ampersandmcd/OpenSwarm/Docs/03-Hardware.md

# OpenSwarm Documentation: Hardware

## Design

When designing the physical side of OpenSwarm, simplicity, flexibility, and affordability were of paramount concern. To study advanced swarm control algorithms requires an adaptable and robust physical foundation; to enable innovation in software, hardware must not get in the way.

As such, hardware design choices were kept generic and open-source; the goal was to keep attention on _what could be done_ with the system, rather than _on the system itself._ The result: an open-source, accessible, portable and hardware-agnostic swarm robotics control framework for the advancement of algorithmic research in distributed systems, multi-agent systems and human-robot interaction.

### Robot

A bi-wheeled, [Arduino](https://www.arduino.cc/)-controlled robot design was chosen for simplicity, flexibility, and affordability's sake; at under $80 per robot, a testbed and swarm of 5 robots can be constructed for under $500. Extensive documentation on the open-source Arduino project is available online along with countless open-source libraries, making the platform ideal for low-cost, high-speed development. Standardized 5V logic and jumper-cable-friendly I/O further solidifes Arduino as the gold-standard of research-oriented development.

WiFi connectivity is provided by the [ESP8266 board](https://en.wikipedia.org/wiki/ESP8266), and mobility is provided by two generic 5v DC motors under control of an [Adafruit TB6612](https://learn.adafruit.com/adafruit-tb6612-h-bridge-dc-stepper-motor-driver-breakout/overview) motor driver. Both components were again chosen on the criteria of simplicity, flexibility, and affordability.

### Testbed

To keep with the theme of simplicity, flexibility, and affordability, the testbed consists of only three parts: open floor space (25-100 ft<sup>2</sup>), an overhead webcam for visual tracking and robot localization, and a router to enable UDP communication between a central server and client robots. These three elements are all that's needed to turn a classroom, basement, or bedroom into one's own research lab.

## Architecture

### Robot

Included below is a bill of materials necessary for each robot's construction, followed by a wiring diagram and images of a finished robot. Note that the photoresistor is optional, and could be replaced by any sensor relevant to the nature of an experiment for data feedback to the central server.

| Item | Quantity | Price |
| --- | --- | --- |
| [Arduino UNO R3](https://www.amazon.com/ELEGOO-Board-ATmega328P-ATMEGA16U2-Compliant/dp/B01EWOE0UU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) | 1 | \$12 |
| [ESP8266](https://www.amazon.com/KeeYees-Internet-Development-Wireless-Compatible/dp/B07PR9T5R5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) | 1 | \$7 |
| [Adafruit TB6612](https://www.amazon.com/Adafruit-TB6612-Stepper-Driver-Breakout/dp/B00VY32VU4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) | 1 | \$5 |
| [Adafruit 3-Layer Round Robot Chassis 2WD with DC Motors](https://www.adafruit.com/product/3244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) | 1 | \$30 |
| [Assorted Jumper Cables](https://www.amazon.com/ELEGOO-Solderless-Flexible-Breadboard-Arduino/dp/B01EV47GI4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) | 1 | \$8 |
| [Generic 9v Battery](https://www.amazon.com/AmazonBasics-Everyday-Alkaline-Batteries-8-Pack/dp/B00MH4QM1S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) | 2 | \$1 |
| [Generic 400-pin Breadboard](https://www.amazon.com/Breadboard-Solderless-Prototype-PCB-Board/dp/B077DN2PS1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) | 2 | \$5 |
| [Generic 9v Battery Hookup](https://www.amazon.com/Battery-Connector-Leather-Housing-Connection/dp/B06X8YZJ64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) | 2 | \$0.50  |
| [Generic 4-Pin Terminal](https://www.amazon.com/Antrader-5-08mm-4P-Pluggable-Terminal-Connector/dp/B07B9R5BQH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) | 1 | \$0.50  |
| [Generic 7805 Voltage Regulator](https://www.amazon.com/Voltage-Regulator-Linear-L7805CV-Positive/dp/B07H9M9SFM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) | 1 | \$0.50  |
| [Generic 0.1uF Capacitor](https://www.amazon.com/Projects-B-0002-C11-Ceramic-Capacitor-0-1uF/dp/B00E6PNOXU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)  | 1 | \$0.50  |
| [Generic 6-Pin Switch](https://www.amazon.com/Position-Vertical-Switch-Electronics-Project/dp/B07F7PNDGM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) | 2 | \$0.50  |
| [Generic LED](https://www.amazon.com/Lights-Emitting-Assortment-Arduino-300-Pack/dp/B00UWBJM0Q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) | 5 | \$0.50  |
| [Generic Potentiometer](https://www.amazon.com/Trimpot-Variable-Resistor-Potentiometer-Assortment/dp/B071WW6VN8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) | 1 | \$0.50  |
| [Generic 220Ω Resistor](https://www.amazon.com/AUSTOR-Resistors-Assortment-Resistor-Experiments/dp/B07BKRS4QZ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) | 5 | \$0.50  |
| [Generic 400-pin Breadboard](https://www.amazon.com/Breadboard-Solderless-Prototype-PCB-Board/dp/B077DN2PS1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) | 2 | \$5 |
| [(Optional) Generic Photoresistor](https://www.amazon.com/MCIGICM-Photoresistor-Sensitive-Resistor-Dependent/dp/B07PF3CWW9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) | 1 | \$0.50  |
| [(Optional) 3D Printed Casing]() | 1 | \$2 |
| **Total** | | \$79.50 |

The schematic below (from [this Fritzing file](../Hardware/Fritzing/RobotSchematic.fzz)) diagrams the architecture of each OpenSwarm robot:

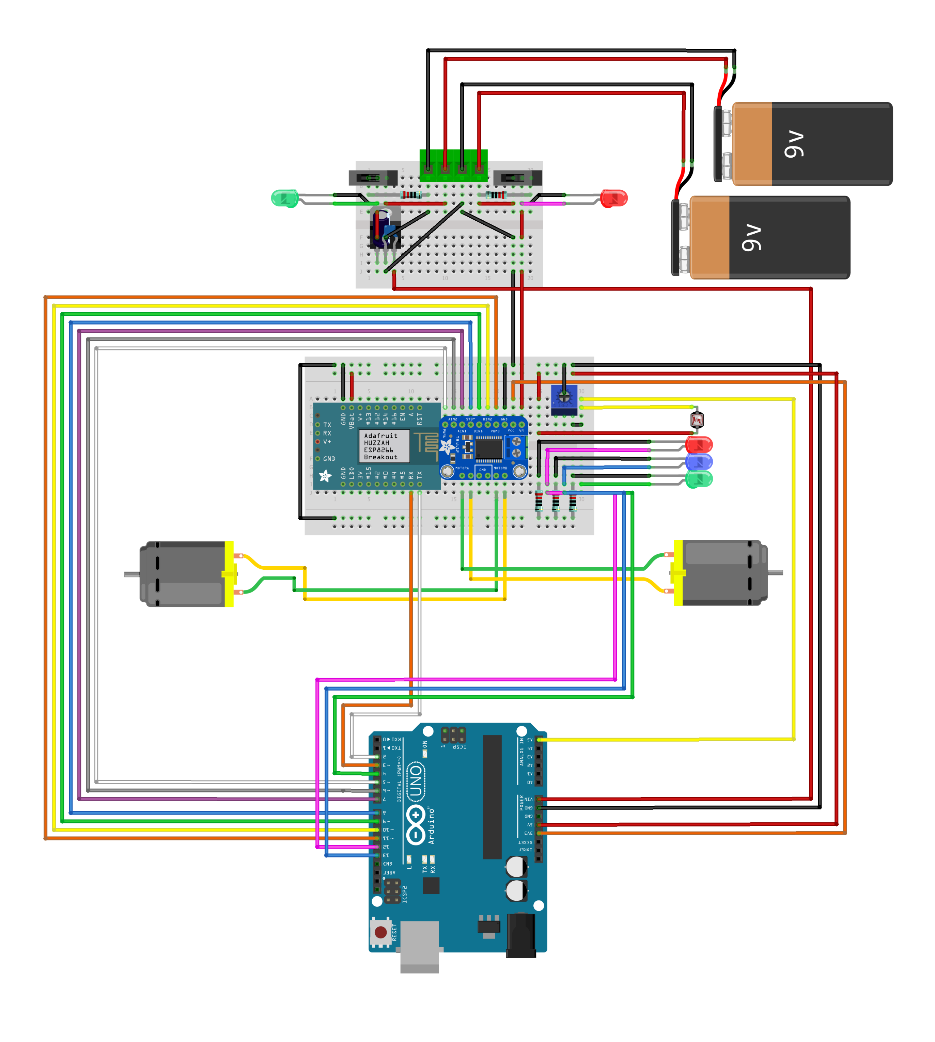
[picture p2: Docs/Images/RobotSchematic.png]


An assembled robot with breadboards, motors, and controllers mounted to an [Adafruit 3-Layer Chassis](https://www.adafruit.com/product/3244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):

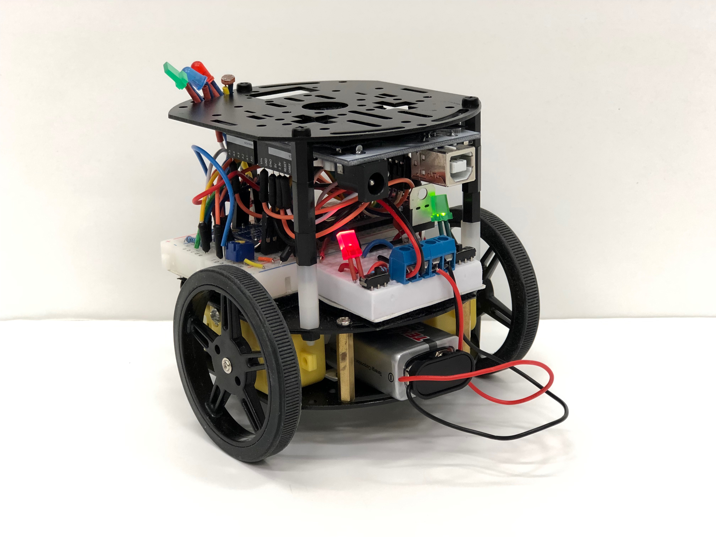
[picture p3: Docs/Images/ISO-Robot-Uncovered.JPG]


An assembled robot complete with [3D-printed casing](../Hardware/3DModels/RobotCover.stl) and visual tracking anchors:

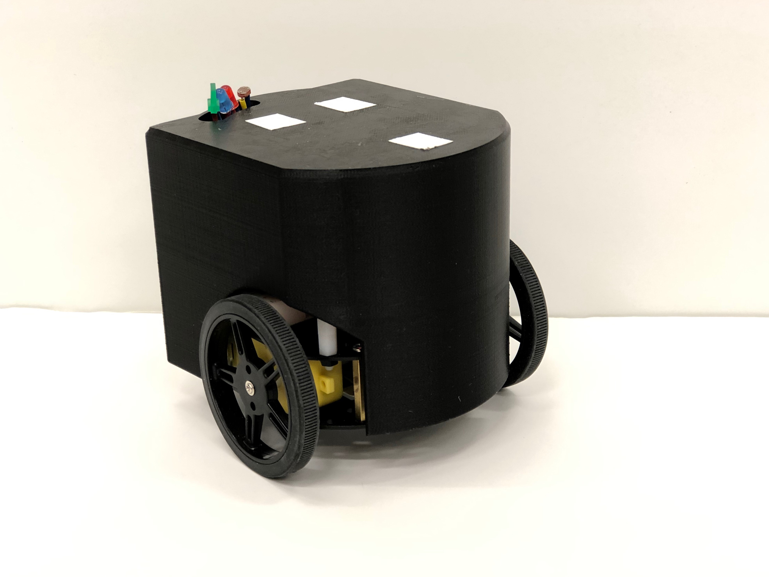
[picture p4: Docs/Images/ISO-Robot-Covered.JPG]


### Testbed

Included below is a bill of materials necessary for the testbed's construction, followed by a conceptual diagram of the testbed and images of the one used when developing OpenSwarm.

| Item | Quantity | Price |
| --- | --- | ----- |
| [Generic Webcam (resolution ≥ 1024x768)](https://www.amazon.com/LARMTEK-Webcam-Computer-Conference-Calling/dp/B07P84DN2K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) | 1 | \$30  |
| [Generic Router](https://www.amazon.com/TP-Link-N450-Wi-Fi-Router-TL-WR940N/dp/B001FWYGJS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) | 1 | \$20  |
| Open Floor Space (25-100 ft<sup>2</sup>) with Overhead Mount for Webcam | 1 | - |
| **Total** | | \$50  |

A conceptual diagram of the testbed setup:

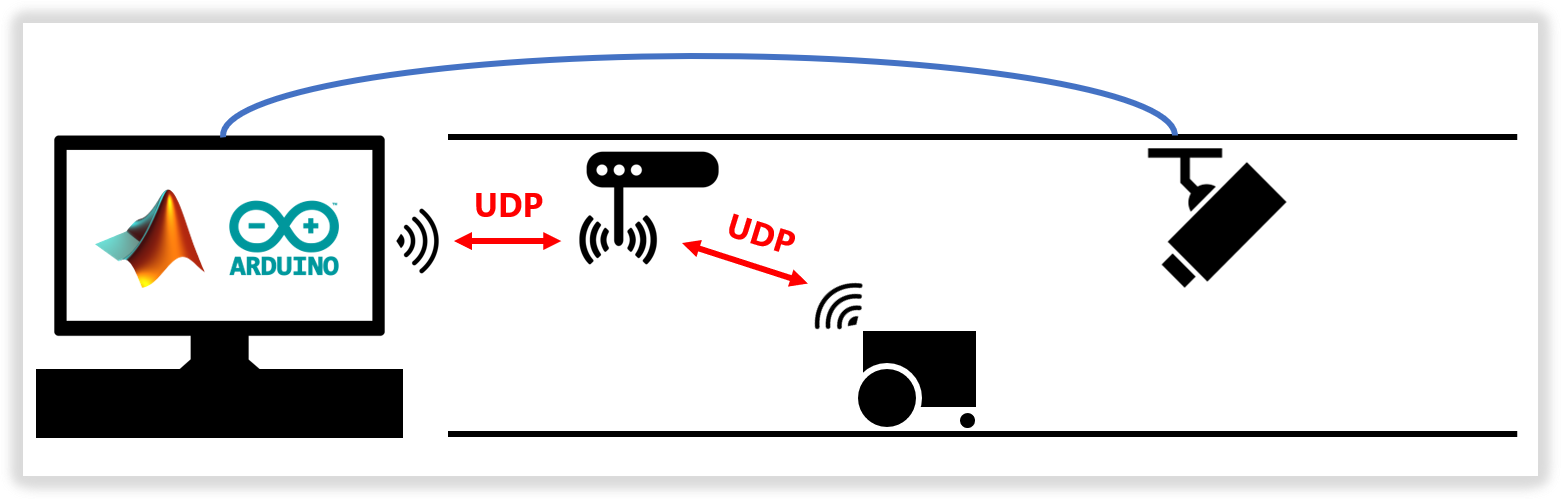
[picture p5: Docs/Images/TestbedSchematic.png]


Testbed used to develop OpenSwarm (approximately 10ft x 10ft; router not pictured). Note that the dark flooring enables visual tracking of the white anchor points on each robot:



Webcams mounted above the testbed used to develop OpenSwarm; note that only one is necessary for visual tracking in Matlab (the second is for simultaneous video capture when running experiments):

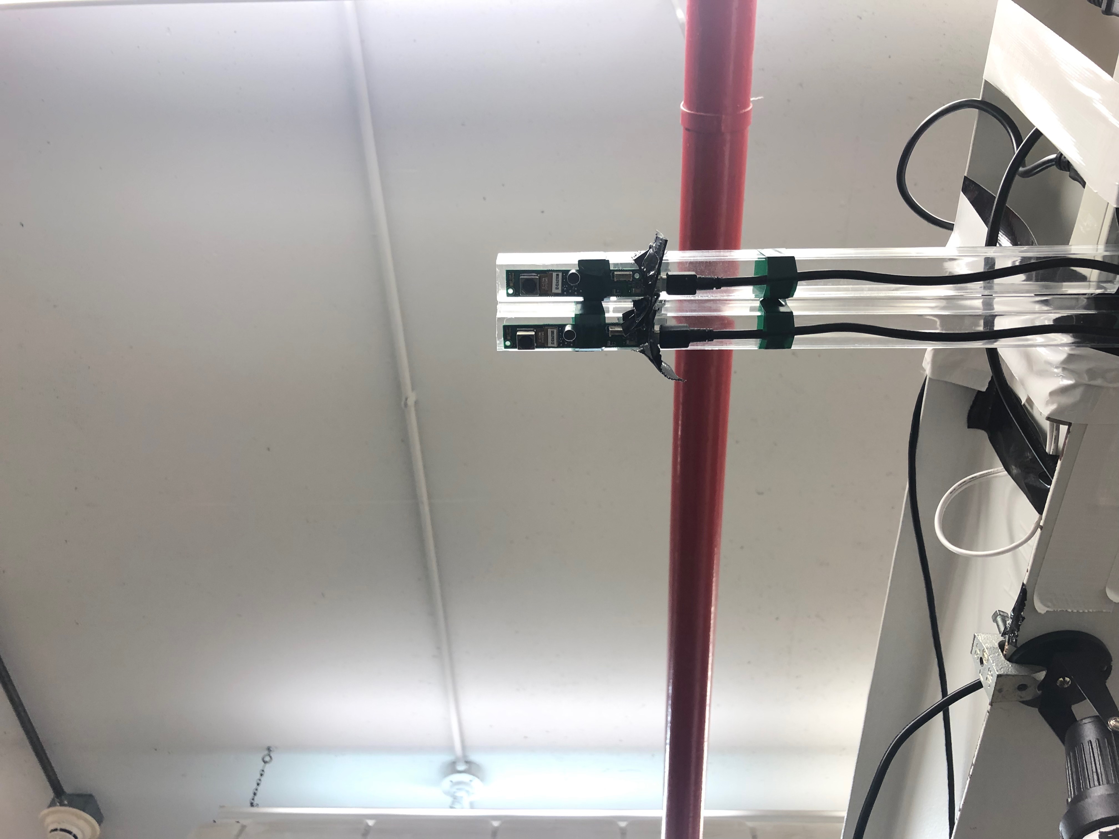
[picture p6: Docs/Images/TestbedWebcam.JPG]


<a href=02-Getting-Started.md>Previous: Getting Started</a>

<a href=04-Software.md>Next: Software</a>
