ampersandmcd/OpenSwarm/Docs/06-References.md

# OpenSwarm Documentation: References

The OpenSwarm library leverages a number of online projects as dependencies, and does not claim ownership or authorship of any of them. Rather, they are included in the repository for the sake of convenience and version stability; it is known that the included versions integrate properly with OpenSwarm's codebase.

As creators of OpenSwarm, we express our most sincere gratitude and respect to those who developed each project. Without each of them, OpenSwarm would not have been possible.

For more information about and most recent versions of each dependency, visit the links below.

### Arduino

- [avr Arduino Core Library](https://github.com/arduino/ArduinoCore-avr)
- [MMEmotor Library](http://web.cecs.pdx.edu/~gerry/class/ME491/notes/motor_driver_TB6612_hookup.html)
- [avr-libc/util Library](https://www.nongnu.org/avr-libc/user-manual/dir_586ad3c2f85d776b984733890d824e3e.html)
- [WiFiEsp Library](https://github.com/bportaluri/WiFiEsp)

### ESP

- [ESP Flash Download Tool](https://www.espressif.com/en/support/download/other-tools)
- [ESP8266 NONOS SDK](https://github.com/espressif/ESP8266_NONOS_SDK)

### Matlab

- [Gaussian Processes for Machine Learning (gpml) Library](http://www.gaussianprocess.org/gpml/)
- [Lloyd's Algorithm Implementation by Aaron Becker](https://www.mathworks.com/matlabcentral/fileexchange/41507-lloydsalgorithm-px-py-crs-numiterations-showplot)
- [Minimum Enclosing Circle Algorithm Implementation by Yazan Ahed](https://www.mathworks.com/matlabcentral/fileexchange/6457-minimum-enclosing-circle)
