ampersandmcd/OpenSwarm/Docs/Images/Diagrams.pptx

Target Positions

OpenSwarm

- Tracks, logs, and returns robot positions to control algorithm
- Determines directions to send to each robot given current and target positions
- Sends directional commands until robots converge on targets
- Receives, logs, and returns sensor data read by each robot

Control Algorithm

- Processes system state data from OpenSwarm
- Updates robot target positions with objective function
- Returns new target positions to OpenSwarm

Current Positions
Past Positions
Current Sensor Data
Past Sensor Data

## Slide 2

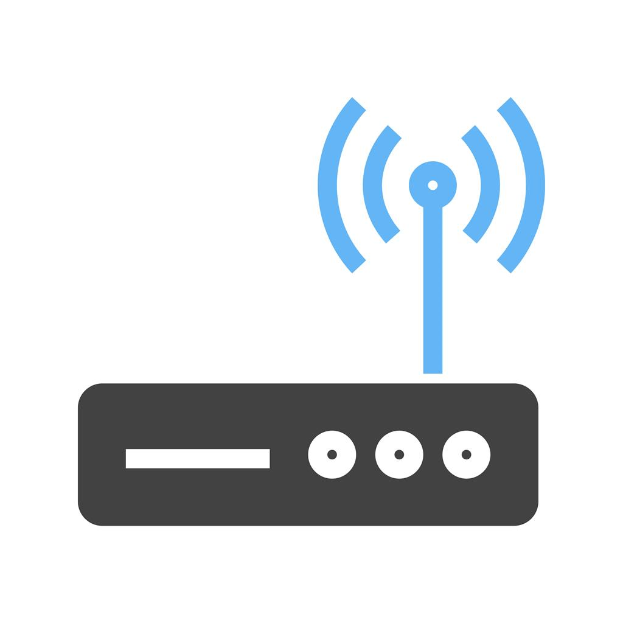
[picture p8: figure]
Image result for router icon
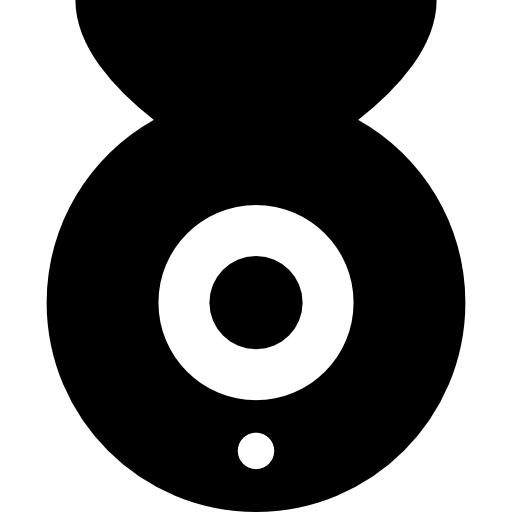
[picture p9: figure]
Image result for webcam icon

5’-10’

5’-10’

## Slide 3

Nose

Tail

Robot L

Robot R
