ampersandmcd/OpenSwarm/Docs/00-Table-of-Contents.md

# OpenSwarm Documentation: Table of Contents

## Table of Contents

1. [Introduction](01-Introduction.md)
   - What is Swarm Robotics?
   - What is OpenSwarm?
   - What's Next?
1. [Getting Started](02-Getting-Started.md)
   - Testbed Setup
   - Robot Setup
   - Software Setup
   - Next Steps
1. [Hardware](03-Hardware.md)
   - Design Considerations
     - Robot
     - Testbed
   - Architecture Overview
     - Robot
     - Testbed
1. [Software](04-Software.md)
   - Design Considerations
     - Server-Side (Matlab)
     - Client-Side (Arduino)
   - Architecture Overview
     - Server-Side (Matlab)
     - Client-Side (Arduino)
1. [Demos](05-Demos.md)
   - Pathfinder

## Appendices

1. [Troubleshooting](A1-Troubleshooting.md)
2. [Contact](A2-Contact.md)

<a href=01-Introduction.md>Next: Introduction</a>
