ampersandmcd/OpenSwarm/Docs/Images/ArduinoFlow.png

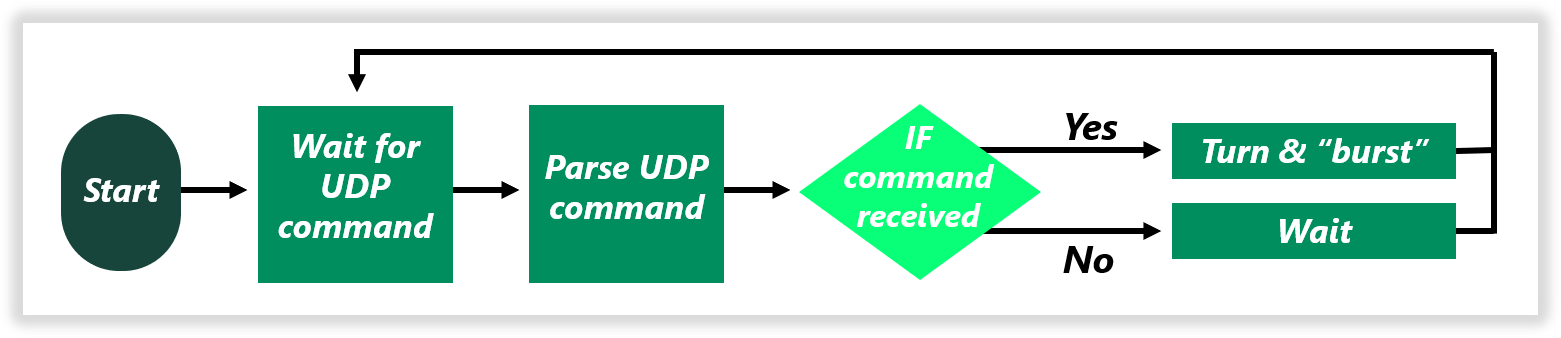
Docs/Images/ArduinoFlow.png
