ampersandmcd/OpenSwarm/Docs/Images/MatlabFlow.png

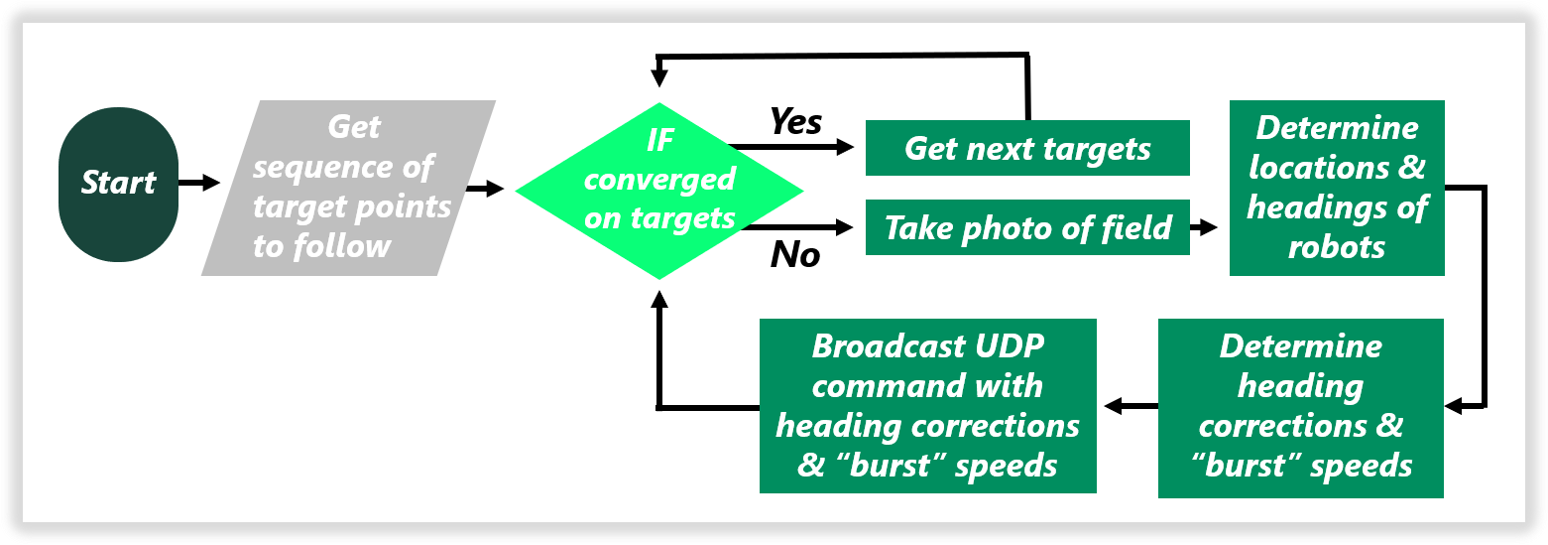
Docs/Images/MatlabFlow.png
