ampersandmcd/OpenSwarm/Docs/Images/SwarmCircleThumbnail.PNG

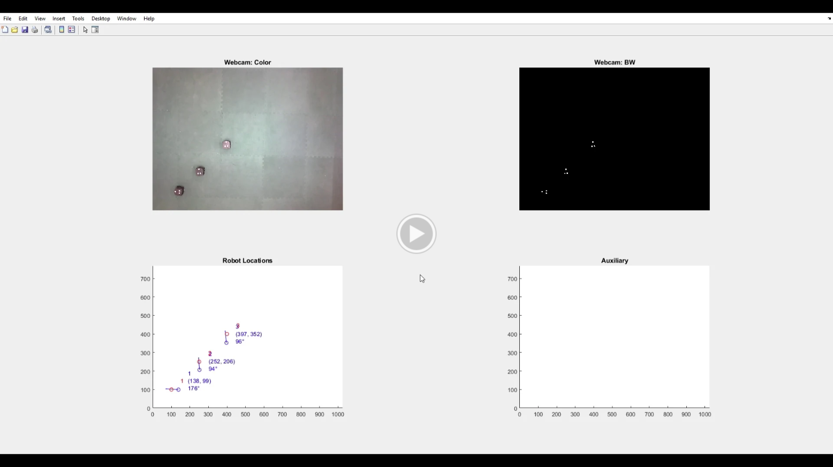
Docs/Images/SwarmCircleThumbnail.PNG
