ampersandmcd/OpenSwarm/Matlab/Data/prior5_confidence0.8.PNG

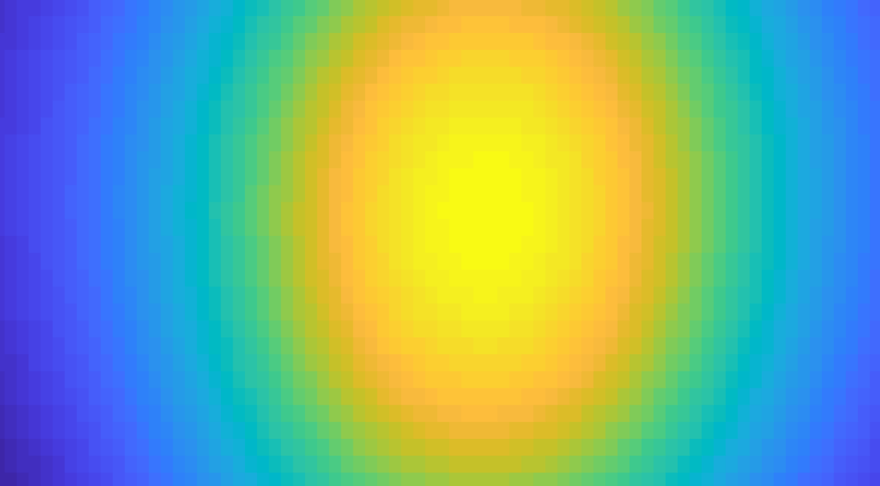
Matlab/Data/prior5_confidence0.8.PNG
