ampersandmcd/OpenSwarm/Matlab/Data/prior5_confidence0.8_winter.PNG

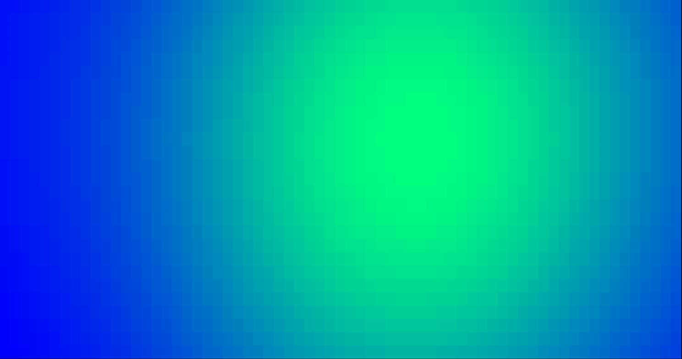
Matlab/Data/prior5_confidence0.8_winter.PNG
