ampersandmcd/OpenSwarm/Matlab/Data/prior6_confidence0.8_winter.PNG

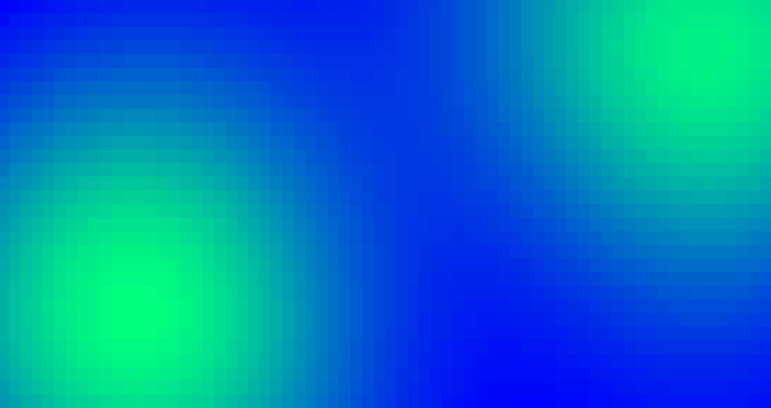
Matlab/Data/prior6_confidence0.8_winter.PNG
