ampersandmcd/OpenSwarm/Media/2.19.19 Panorama BW.jpg

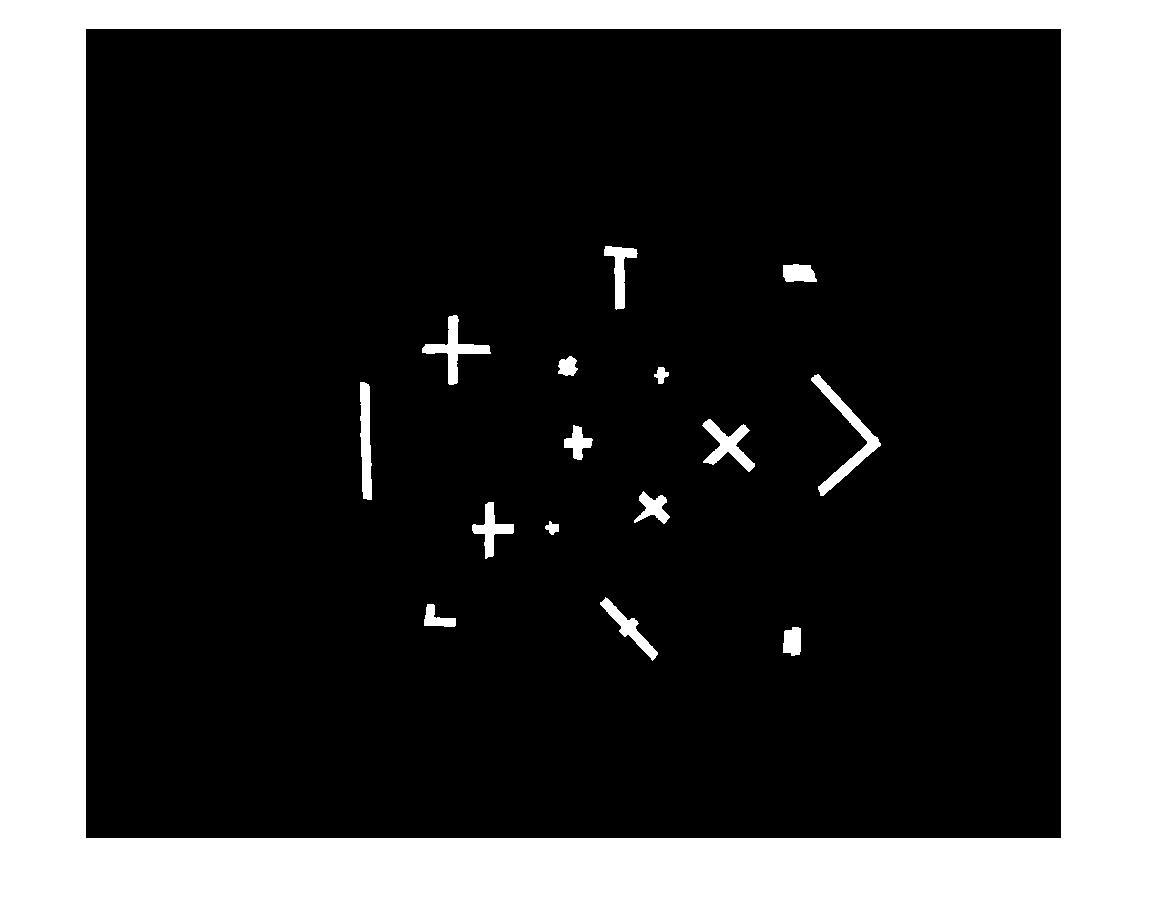
Media/2.19.19 Panorama BW.jpg
