ampersandmcd/OpenSwarm/Media/2.19.19 Panorama Crop.jpg

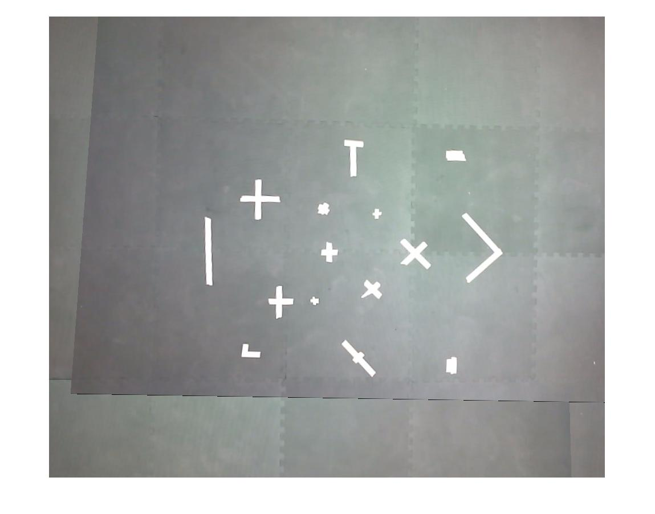
Media/2.19.19 Panorama Crop.jpg
