ampersandmcd/OpenSwarm/Media/2.19.19 Panorama.jpg

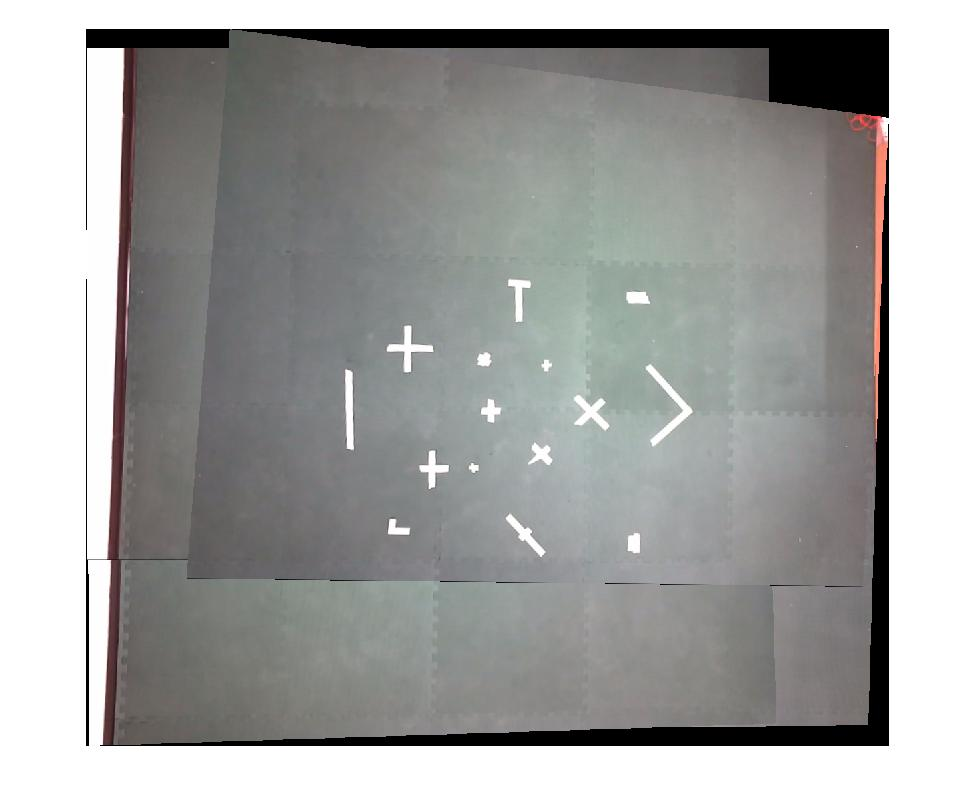
Media/2.19.19 Panorama.jpg
