ampersandmcd/OpenSwarm/Media/2.22.19 Successful Position & Heading Tracking.PNG

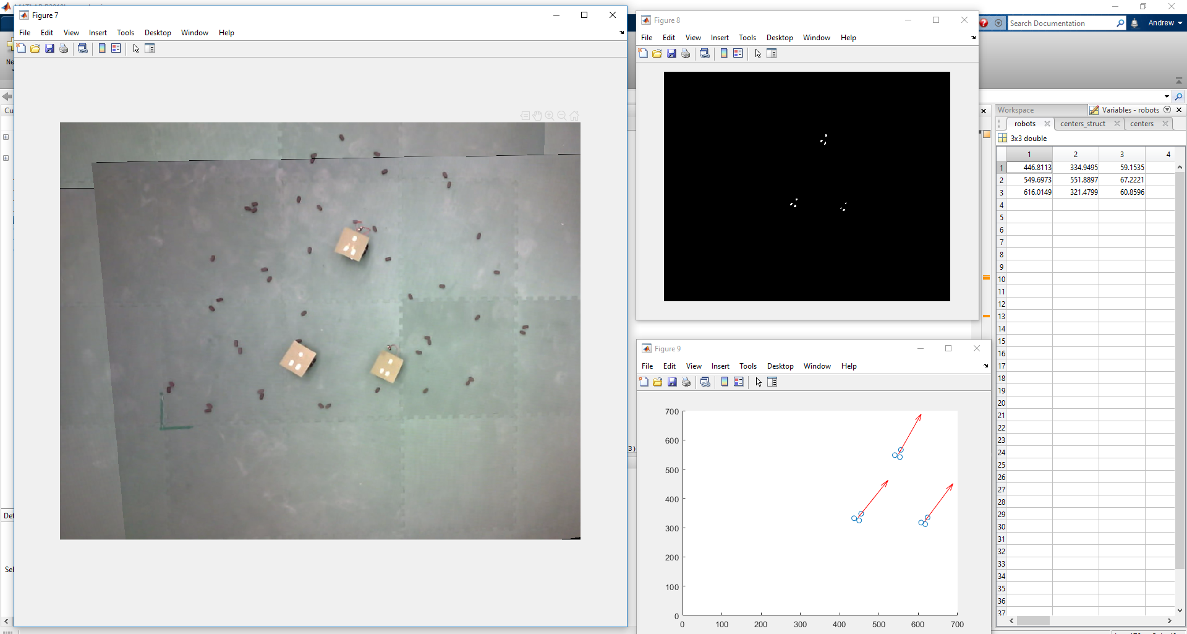
Media/2.22.19 Successful Position & Heading Tracking.PNG
