ampersandmcd/OpenSwarm/Media/AAAI_Exploit1.png

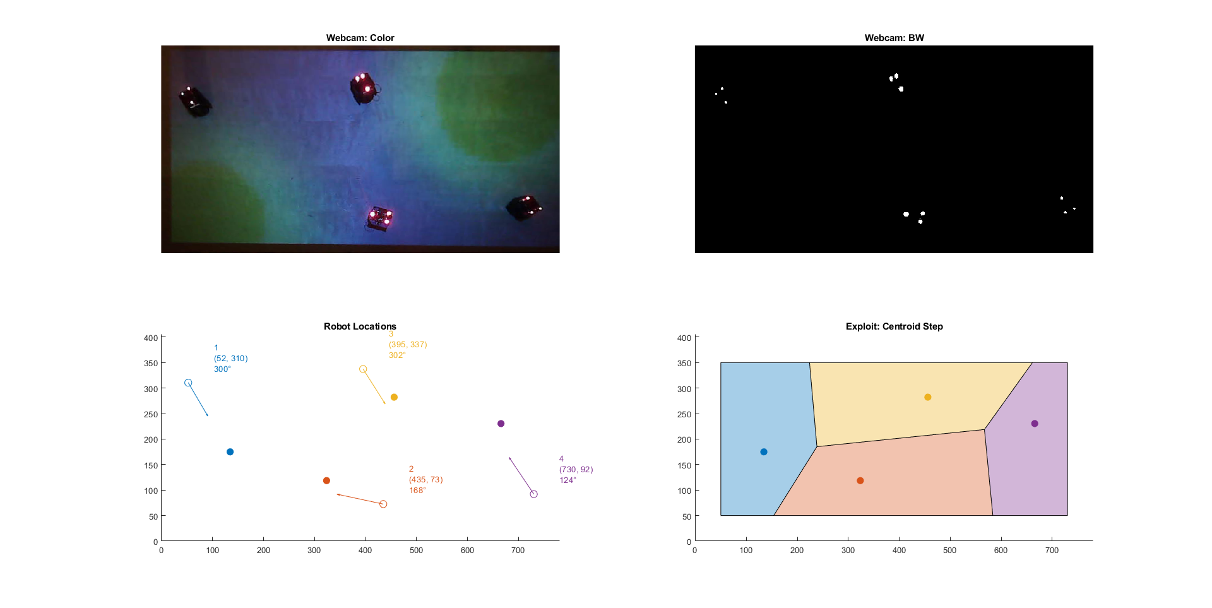
Media/AAAI_Exploit1.png
