ampersandmcd/OpenSwarm/Media/AAAI_Explore1.png

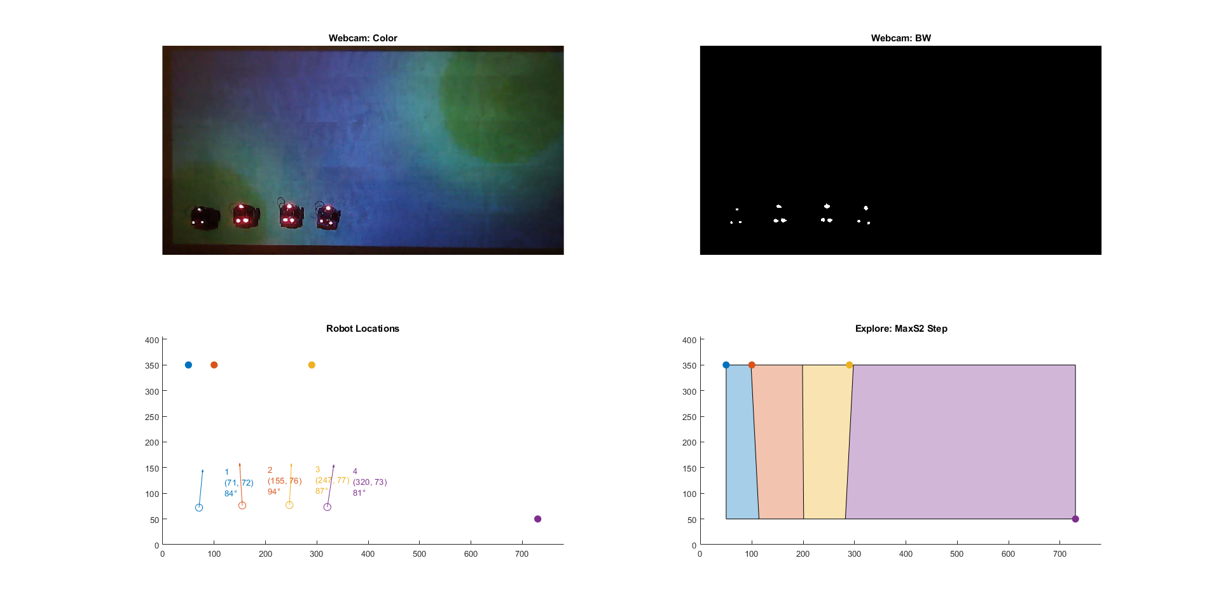
Media/AAAI_Explore1.png
