ampersandmcd/OpenSwarm/Media/AAAI_Explore3.png

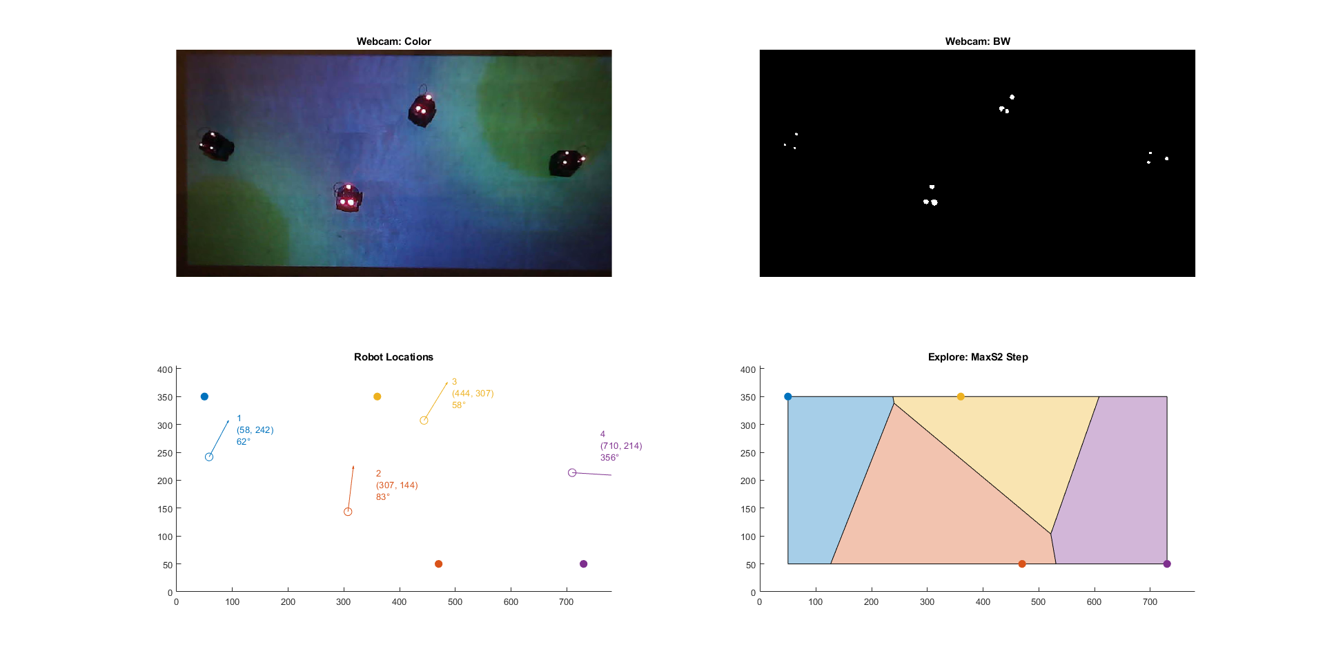
Media/AAAI_Explore3.png
