ampersandmcd/OpenSwarm/Media/AAAI_GP2.png

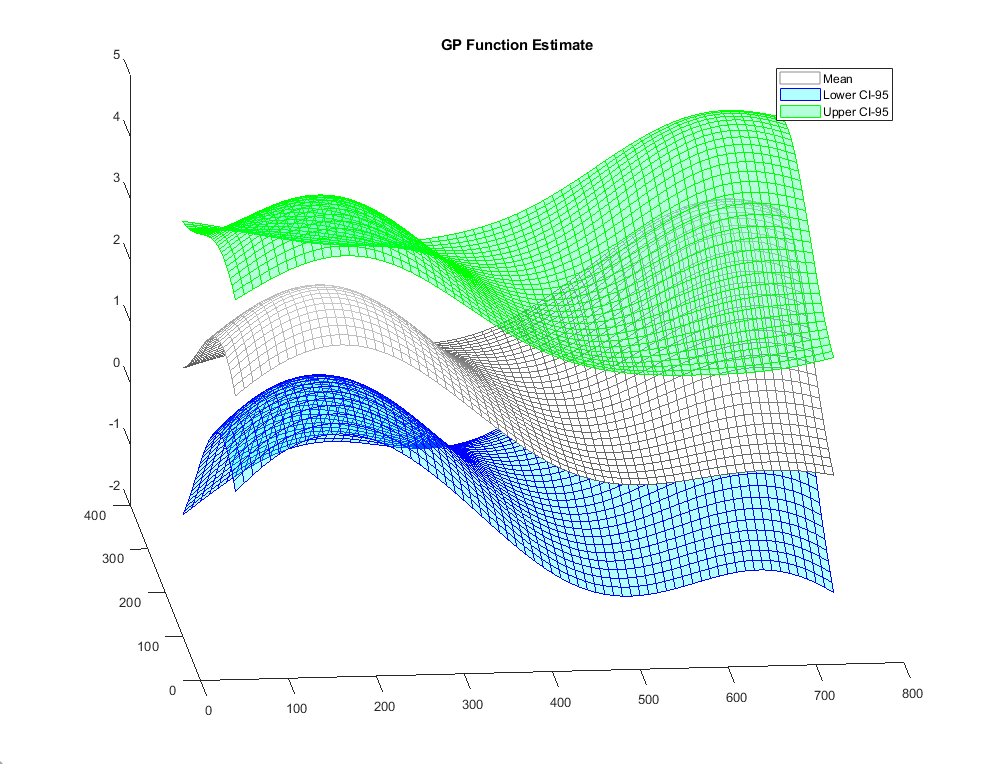
Media/AAAI_GP2.png
