ampersandmcd/OpenSwarm/Media/AAAI_GP.png

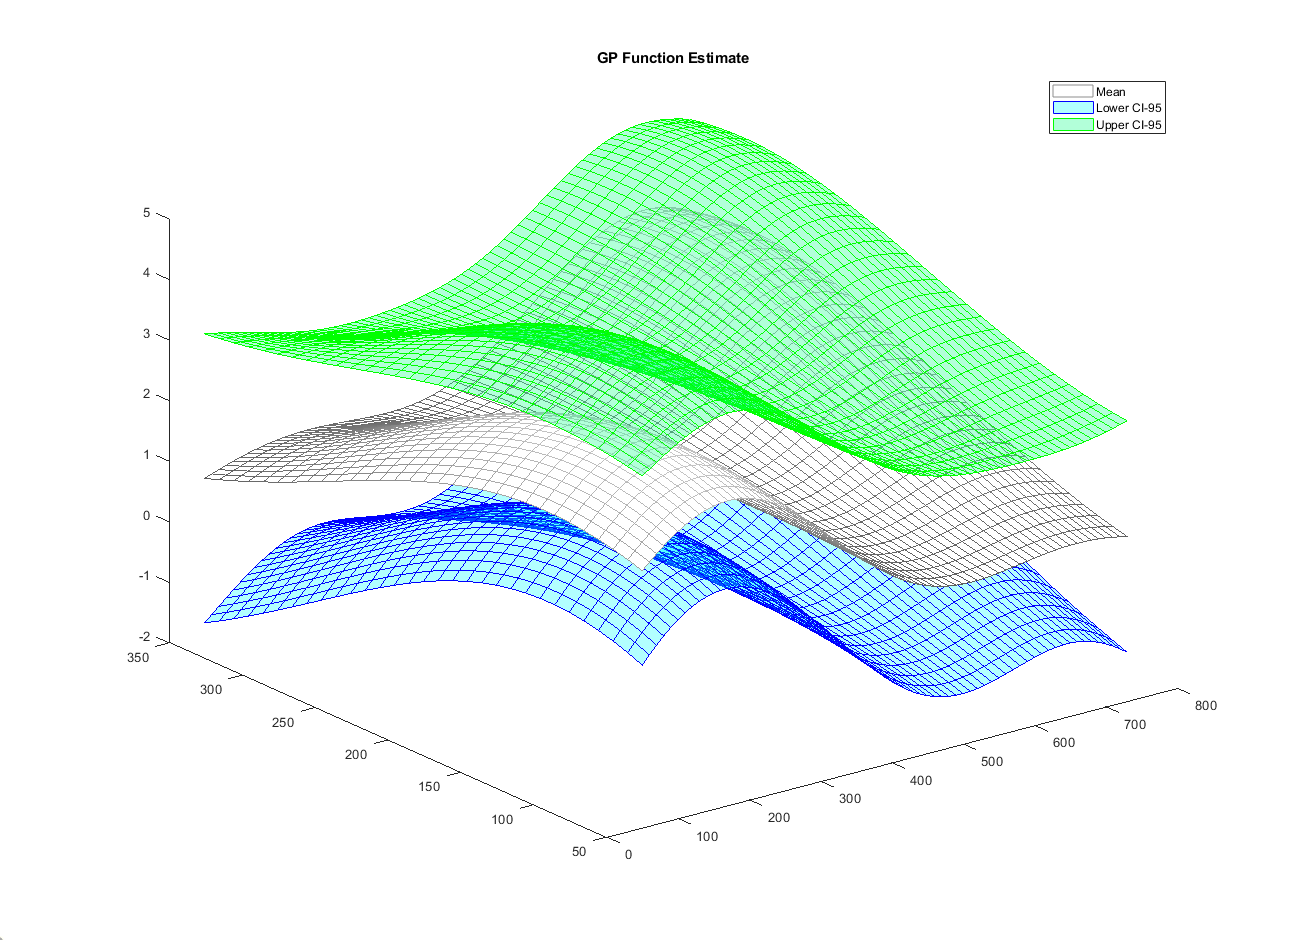
Media/AAAI_GP.png
