ampersandmcd/OpenSwarm/Media/AAAI_Input.png

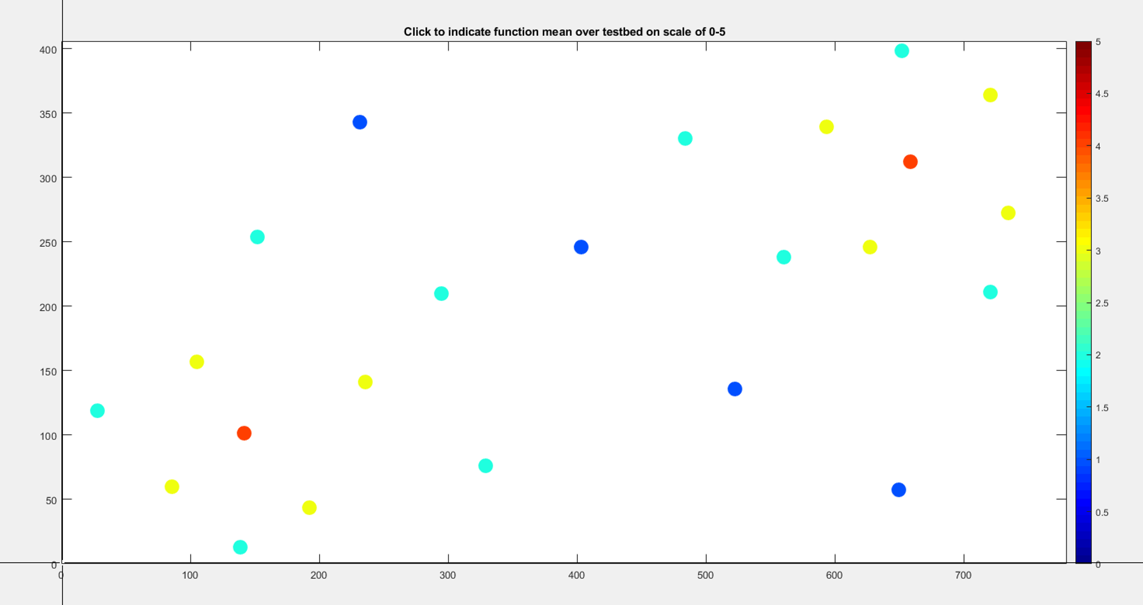
Media/AAAI_Input.png
