ampersandmcd/OpenSwarm/Media/CircleTourFast.gif

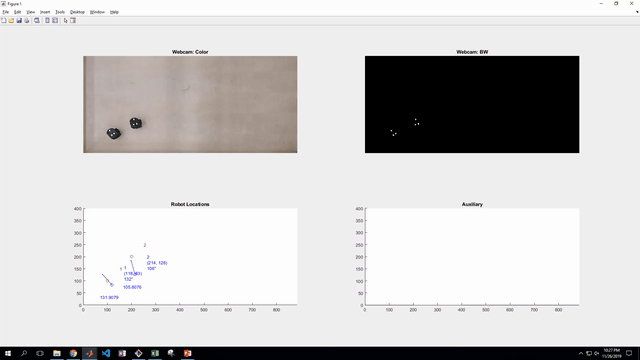
Media/CircleTourFast.gif
