ampersandmcd/OpenSwarm/Media/Four Corners Gaussian Kernel Cartogram Isometric View (sigma=1e4, nRobots=10).jpg

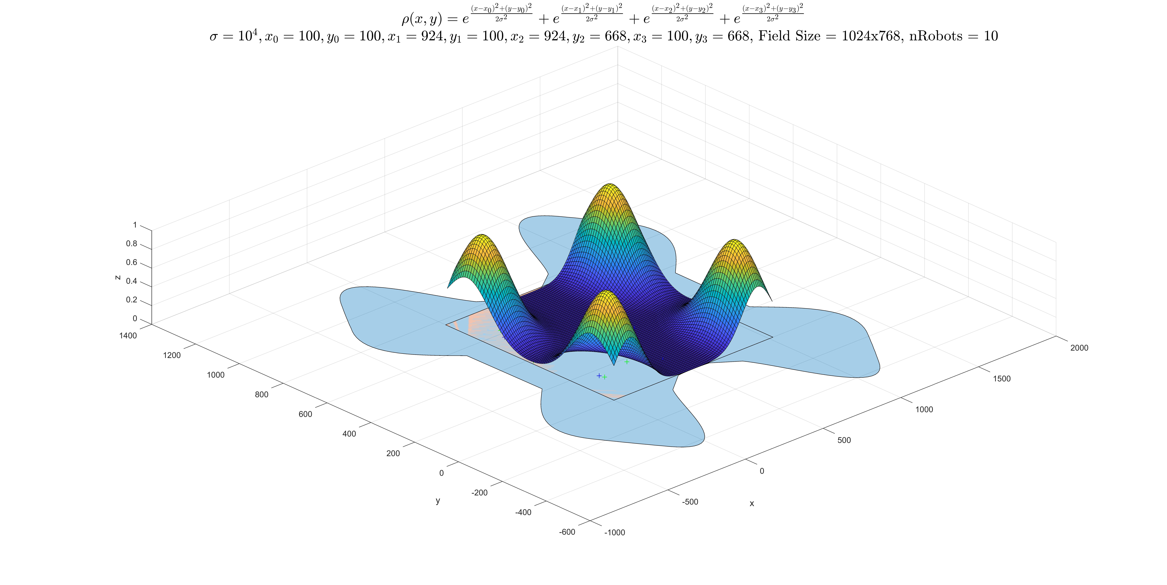
Media/Four Corners Gaussian Kernel Cartogram Isometric View (sigma=1e4, nRobots=10).jpg
