ampersandmcd/OpenSwarm/Media/Gaussian Kernel Cartogram (100, 100, sigma=1e5, nRobots=10).jpg

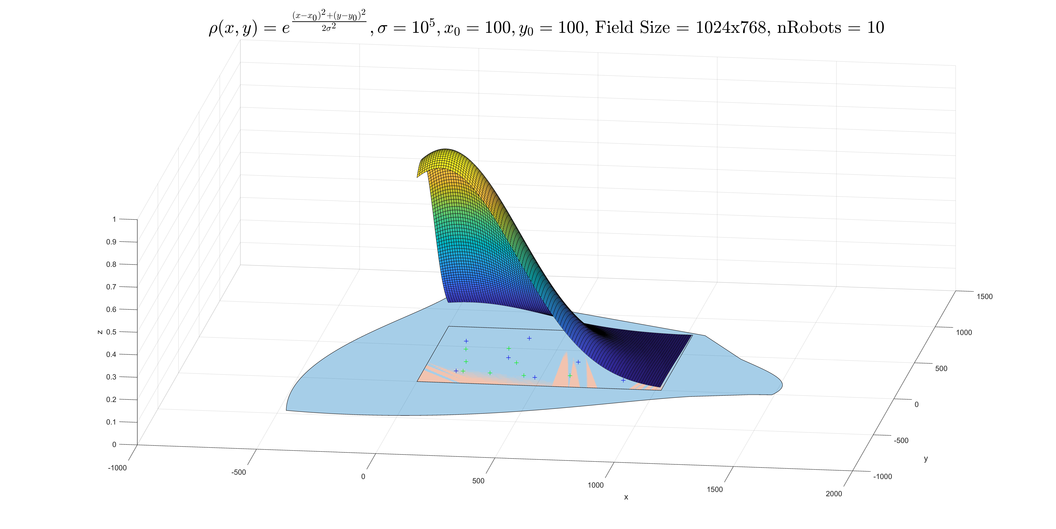
Media/Gaussian Kernel Cartogram (100, 100, sigma=1e5, nRobots=10).jpg
