ampersandmcd/OpenSwarm/Media/Gaussian Kernel Cartogram (center, center, sigma=1e5, nRobots=10).jpg

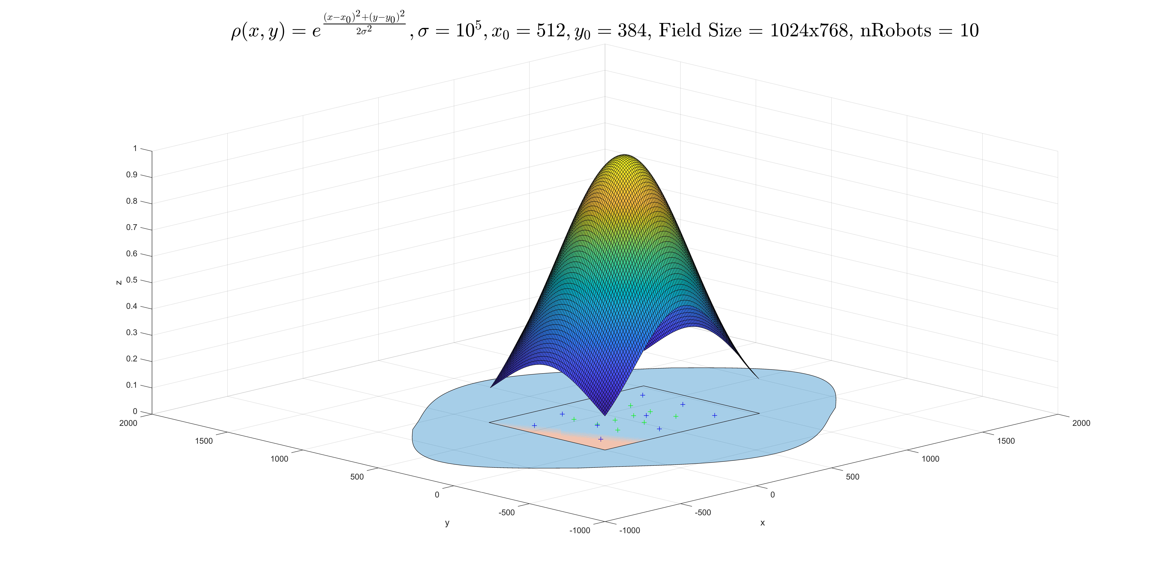
Media/Gaussian Kernel Cartogram (center, center, sigma=1e5, nRobots=10).jpg
