ampersandmcd/OpenSwarm/Media/IROS_lofi.png

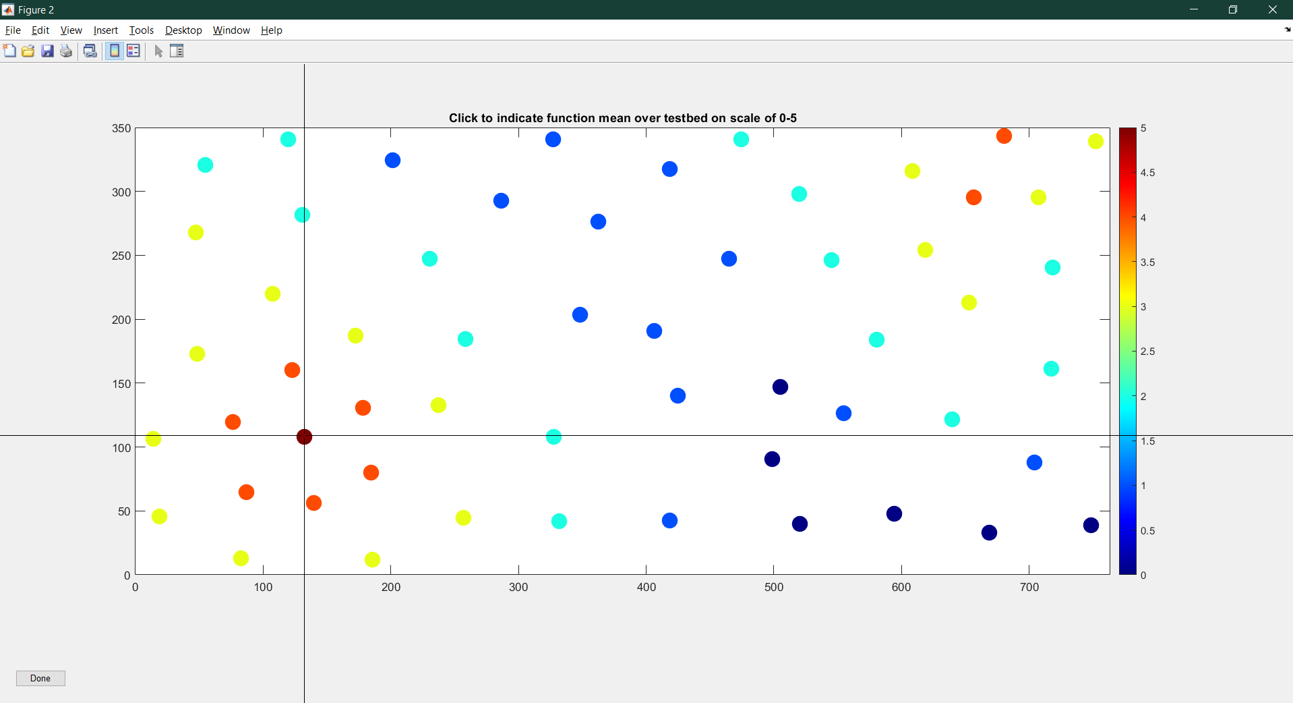
Media/IROS_lofi.png
