ampersandmcd/OpenSwarm/Hardware/3DModels/RobotCover.stl

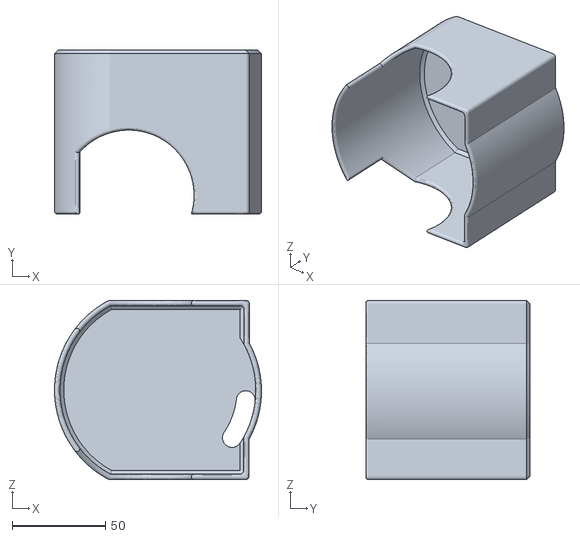
[picture p59: CAD file, 2019-09-26]
Hardware/3DModels/RobotCover.stl
110.9 x 88.0 x 96.2
