ampersandmcd/OpenSwarm/(list of files, cad)

Other CAD files:
Hardware/3DModels/RobotCover.ipt
