ampersandmcd/OpenSwarm/(list of files, drawings)

Other design files:
Hardware/Fritzing/RobotSchematic.fzz
