ampersandmcd/OpenSwarm/(commit log)

2019-08-26 add arduino repo
2019-08-26 clean up Arduino libraries and remove old files
2019-08-27 configure settings to develop Arduino in VS Code
2019-08-28 add json ArduinoJson library
2019-09-01 refactor config into Configuration.h
    [Configuration.h]
2019-09-01 refactor main loop
    [Configuration.h]
2019-09-01 abstract drive methods into Driver.h and debugging into Utils.h
2019-09-01 format spacing and refactor Debug and Configuration
    [Configuration.h]
2019-09-01 finalize after successful on-field test
    [Configuration.h]
2019-09-02 refactor to include LDR feedback and reduce memory useage
    [Configuration.h]
2019-09-02 successful end-to-end ldr feedback test
    [Configuration.h]
2019-09-02 end-to-end lightmap functionality with LED indicators
    [Configuration.h]
2019-09-08 add Navigator class and SetTargetsFromCSV function
    [test_targets.csv]
2019-09-08 finish navigator read from csv and successfully test with two target sets
    [test_targets.csv]
2019-09-09 add Navigator.IsConverged and Navigator.GetDirections
    [test_targets.csv]
2019-09-10 restructure file hierarchy
    [test_targets.csv]
2019-09-10 successfully test dry-run of code; implement pathfinder for real test
    [test_path.csv]
2019-09-13 add homing functionality in navigator.m; reconfigure max speed from 100 - 255
2019-09-13 update pathfinder example to read in and travel in circle
    [circle.csv]
2019-09-13 reduce speed and increase delay -- not robust with high speed or low delay after empirical tests
    [circle.csv]
2019-09-15 refactor media and add hardware info
    [RobotSchematic.fzz]
2019-09-15 add 3d models to hardware folder
    [Robot Cover.ipt, Robot Cover.stl]
2019-09-15 add to 03-Hardware.md documentation
    [RobotCover.ipt, RobotCover.stl]
2019-09-23 add ESP directory for flashing and additional construction images; finish hardware setup of gettingstarted.md
    [ESP32_RF_INIT.xlsx, ESP8266_RF_init.xls, ESP8266_RF_init.xlsx]
2019-11-05 add save / load human-defined prior support
    [prior1.csv]
2019-11-05 add uncertainty reduction algorithm, add planner object, scaffold ClusterTSPTour function, improve visualizations of GP sampling process
    [prior1.csv, prior1_confidence1.csv, prior1_confidence10.csv, prior1_confidence2.csv, prior1_confidence3.csv, prior1_confidence4.csv, prior1_confidence5.csv]
2019-11-19 refactor training point construction algorithm; implement scaffold of bernoulli algorithm; implement outline of data_centroid and data_maxu methods; implement helper methods to accelerate centroid an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
    [prior1_confidence0.2.csv, prior1_confidence0.5.csv, prior1_confidence0.8.csv, prior1_confidence0.csv, prior1_confidence1.0.csv, prior1_confidence5.csv, prior_corners_confidence1.csv, prior_corners_confidence5.csv]
2019-11-27 finish implementation of new webcam adjustments and save test gif in media folder
    [circle.csv, prior1_confidence0.2.csv, prior1_confidence0.5.csv, prior1_confidence0.8.csv, prior1_confidence0.csv, prior1_confidence1.0.csv, prior_corners_confidence1.csv, prior_corners_confidence5.csv]
2020-01-07 update HILGPC lloyd coverage algorithm and visualizations
    [prior1_confidence0.2.csv, prior1_confidence0.5.csv, prior1_confidence0.8.csv, prior1_confidence0.csv, prior1_confidence1.0.csv, prior_corners_confidence1.csv, prior_corners_confidence5.csv, prior_mountain_confidence5.csv]
2020-01-16 update bounds on algorithm to avoid edge run-offs
    [prior2_confidence0.8.csv]
2020-01-21 add standard numerical centroid computation
    [prior3_confidence0.8.csv, prior4_confidence0.8.csv]
2020-01-22 add new maxs2 method with voronoi in original space
    [prior5_confidence0.8.csv]
2020-01-23 add messenger.ReadMessage() and member variables and modify bernoulli to get samples -- just need to calibrate and scale now
2020-02-02 add AAAI-20 images
    [prior6_confidence0.8.csv]
2020-02-27 successfully integrate mfgp lib from python to matlab
    [dist7_hifi.csv, dist7_lofi.csv]
2020-02-27 tinker and fit working mfgp model
    [dist7_hifi.csv, dist7_lofi.csv]
2020-02-27 set up sample collection
    [collect_hifi.csv, collect_lofi.csv]
2020-02-27 tons of minor changes for simulation readiness
    [collect_MFGP.csv, collect_hifi.csv, collect_lofi.csv]
2020-02-27 recommit from parent dir
    [Configuration.h]
2020-02-28 iros mfgp marathon
    [Configuration.h, collect_MFGP.csv, collect_MFGP_dark.csv, collect_hifi.csv, collect_lofi_dark.csv, lofi_train_dense.csv, lofi_train_double_shifted.csv]
